Molizane/rc2014-ym2149/rc2014-ym2149-schematic.pdf

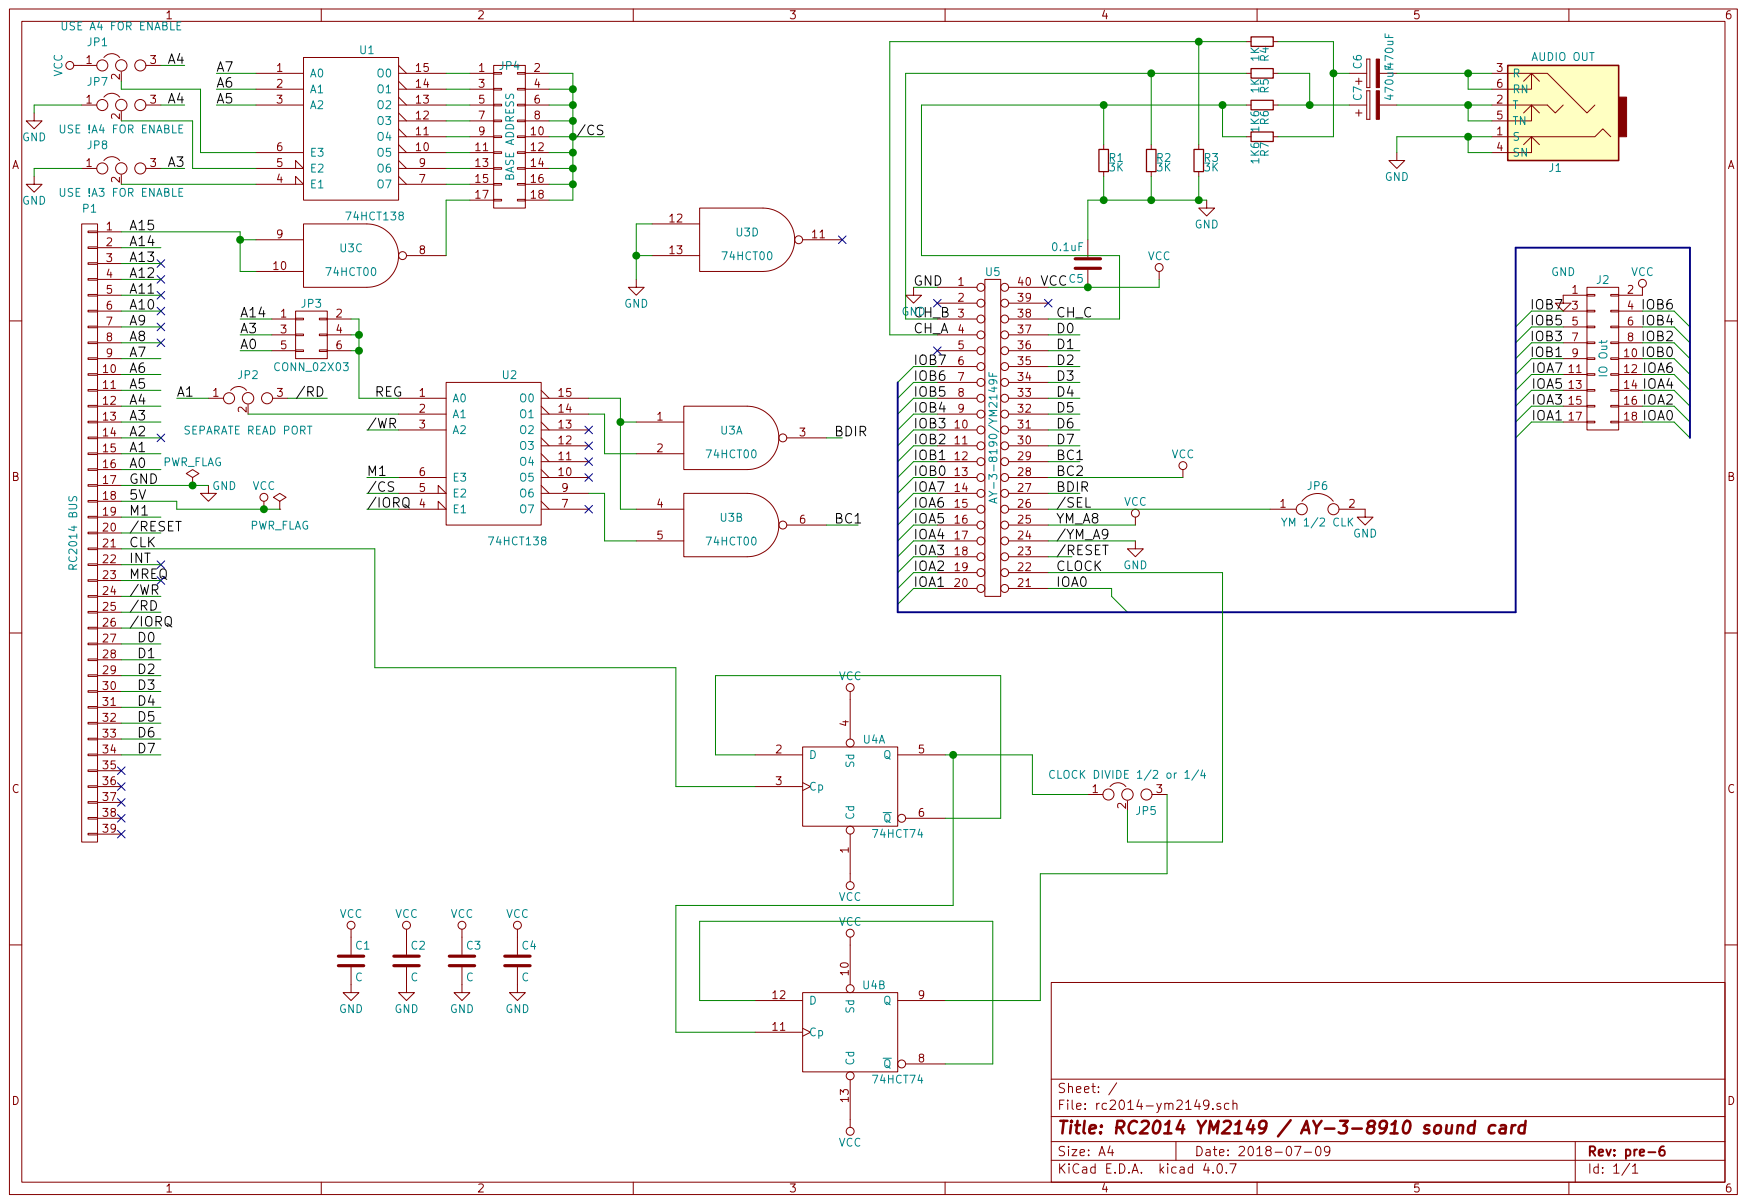
[picture p2: page 1]
