Molizane/rc2014-ym2149/rc2014-ym2149.sch

## KiCad design rc2014-ym2149.sch (2018-07-09)

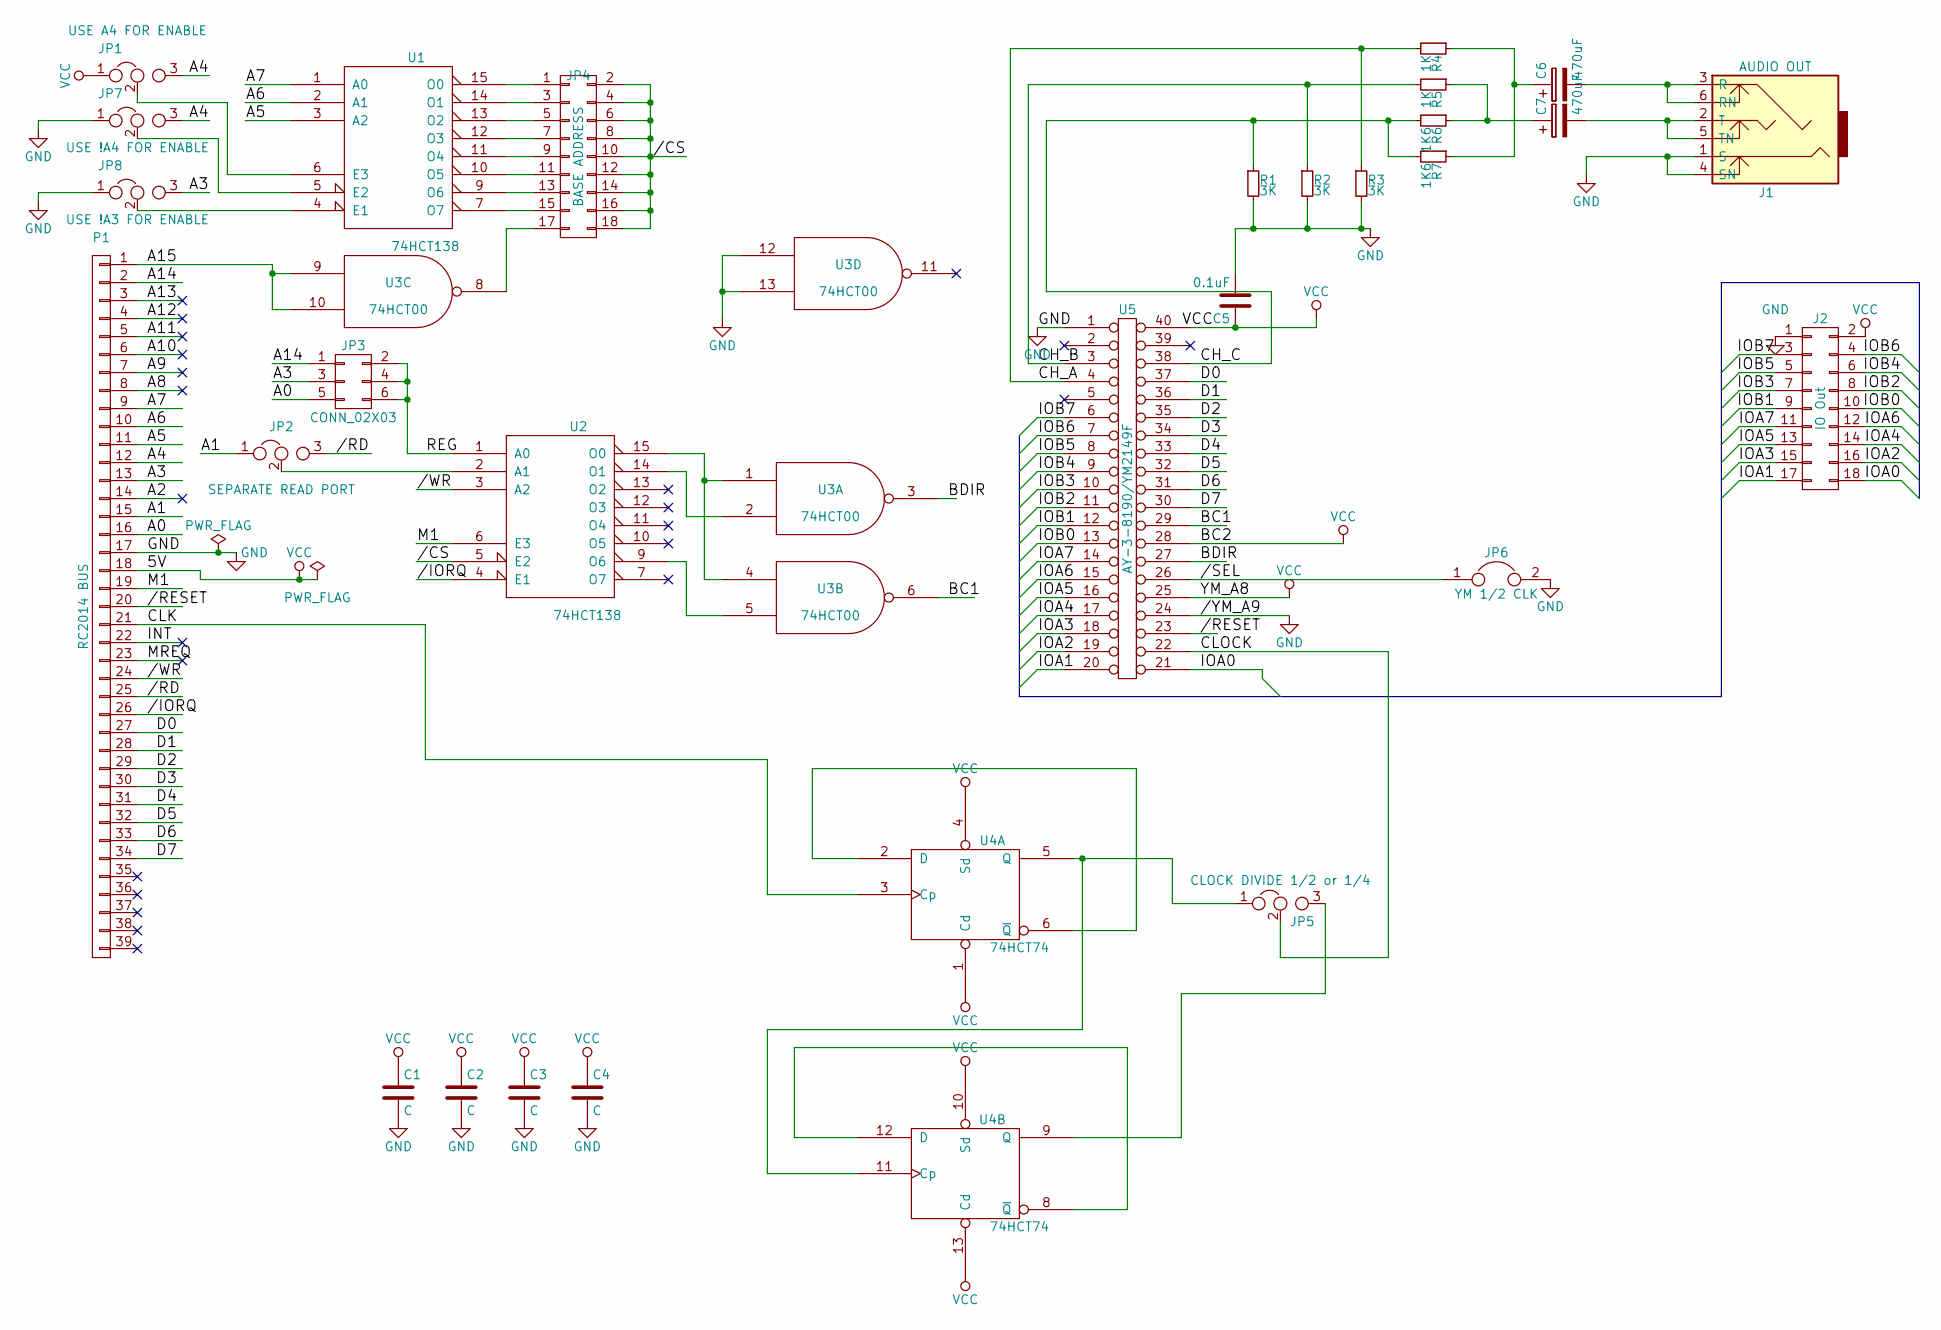
[picture p3: schematic rc2014-ym2149.sch]

Parts:
C1, C2, C3, C4: C; C_Disc_D3.8mm_W2.6mm_P2.50mm
C5: 0.1uF; C_Disc_D3.8mm_W2.6mm_P2.50mm
C6, C7: 470uF; CP_Radial_D6.3mm_P2.50mm
J1: AUDIO OUT; cliff_fcr1295_socket
J2: IO Out; Pin_Header_Straight_2x09_Pitch2.54mm
JP1: USE A4 FOR ENABLE; Pin_Header_Straight_1x03_Pitch2.54mm; MPN CONN 1x03
JP2: SEPARATE READ PORT; Pin_Header_Straight_1x03_Pitch2.54mm
JP3: CONN_02X03; Pin_Header_Straight_2x03_Pitch2.54mm
JP4: BASE ADDRESS; Pin_Header_Straight_2x08_Pitch2.54mm
JP5: CLOCK DIVIDE 1/2 or 1/4; Pin_Header_Straight_1x03_Pitch2.54mm
JP6: YM 1/2 CLK; Pin_Header_Straight_1x02_Pitch2.54mm
JP7: USE !A4 FOR ENABLE; Pin_Header_Straight_1x03_Pitch2.54mm; MPN CONN 1x03
JP8: USE !A3 FOR ENABLE; Pin_Header_Straight_1x03_Pitch2.54mm; MPN CONN 1x03
P1: RC2014 BUS; Pin_Header_Straight_1x39_Pitch2.54mm_NoSilk
R1: 3K; R_Axial_DIN0207_L6.3mm_D2.5mm_P10.16mm_Horizontal; MPN MF25 470R
R2, R3: 3K; R_Axial_DIN0207_L6.3mm_D2.5mm_P10.16mm_Horizontal
R4: 1K; R_Axial_DIN0207_L6.3mm_D2.5mm_P10.16mm_Horizontal; MPN MF25 1K
R5: 1K; R_Axial_DIN0207_L6.3mm_D2.5mm_P10.16mm_Horizontal
R6: 1K6; R_Axial_DIN0207_L6.3mm_D2.5mm_P10.16mm_Horizontal; MPN MF25 1K6
R7: 1K6; R_Axial_DIN0207_L6.3mm_D2.5mm_P10.16mm_Horizontal
U1, U2: 74HCT138; DIP-16_W7.62mm_Socket; MPN CD74HCT138E
U3: 74HCT00; DIP-14_W7.62mm_Socket
U4: 74HCT74; DIP-14_W7.62mm_Socket; MPN SN74HCT74N
U5: AY-3-8190/YM2149F; DIP-40_W15.24mm_Socket

Connections:
/CS: JP4.2, JP4.4, JP4.6, JP4.8, JP4.10, JP4.12, JP4.14, JP4.16, JP4.18, U2.5 (E2)
/IORQ: P1.26, U2.4 (E1)
/RD: JP2.3, P1.25
/RESET: P1.20, U5.23
/SEL: JP6.1, U5.26
/WR: P1.24, U2.3 (A2)
A0: JP3.5, P1.16
A1: JP2.1, P1.15
A2: P1.14
A3: JP3.3, JP8.3, P1.13
A4: JP1.3, JP7.3, P1.12
A5: P1.11, U1.3 (A2)
A6: P1.10, U1.2 (A1)
A7: P1.9, U1.1 (A0)
A8: P1.8
A9: P1.7
A10: P1.6
A11: P1.5
A12: P1.4
A13: P1.3
A14: JP3.1, P1.2
A15: P1.1, U3.9, U3.10
BC1: U3.6, U5.29
BDIR: U3.3, U5.27
CH_A: R3.1, R4.2, U5.4
CH_B: R2.1, R5.2, U5.3
CH_C: R1.1, R6.2, R7.2, U5.38
CLK: P1.21, U4.3 (Cp)
CLOCK: JP5.2, U5.22
D0: P1.27, U5.37
D1: P1.28, U5.36
D2: P1.29, U5.35
D3: P1.30, U5.34
D4: P1.31, U5.33
D5: P1.32, U5.32
D6: P1.33, U5.31
D7: P1.34, U5.30
GND: C1.2, C2.2, C3.2, C4.2, C5.2, J1.1 (S), J1.4 (SN), J2.1, JP6.2, JP7.1, JP8.1, P1.17, R1.2, R2.2, R3.2, U3.12, U3.13, U5.1, U5.24
INT: P1.22
IOA0: J2.18, U5.21
IOA1: J2.17, U5.20
IOA2: J2.16, U5.19
IOA3: J2.15, U5.18
IOA4: J2.14, U5.17
IOA5: J2.13, U5.16
IOA6: J2.12, U5.15
IOA7: J2.11, U5.14
IOB0: J2.10, U5.13
IOB1: J2.9, U5.12
IOB2: J2.8, U5.11
IOB3: J2.7, U5.10
IOB4: J2.6, U5.9
IOB5: J2.5, U5.8
IOB6: J2.4, U5.7
IOB7: J2.3, U5.6
M1: P1.19, U2.6 (E3)
MREQ: P1.23
unnamed: C6.1, R4.1, R7.1
unnamed: C6.2, J1.3 (R), J1.6 (RN)
unnamed: C7.1, R5.1, R6.1
unnamed: C7.2, J1.2 (T), J1.5 (TN)
unnamed: JP1.2, U1.6 (E3)
unnamed: JP2.2, U2.2 (A1)
unnamed: JP4.1, U1.15 (O0)
unnamed: JP4.3, U1.14 (O1)
unnamed: JP4.5, U1.13 (O2)
unnamed: JP4.7, U1.12 (O3)
unnamed: JP4.9, U1.11 (O4)
unnamed: JP4.11, U1.10 (O5)
unnamed: JP4.13, U1.9 (O6)
unnamed: JP4.15, U1.7 (O7)
unnamed: JP4.17, U3.8
unnamed: JP5.1, U4.5 (Q), U4.11 (Cp)
unnamed: JP5.3, U4.9 (Q)
unnamed: JP7.2, U1.5 (E2)
unnamed: JP8.2, U1.4 (E1)
unnamed: U2.9 (O6), U3.5
unnamed: U2.14 (O1), U3.2
unnamed: U2.15 (O0), U3.1, U3.4
unnamed: U4.2 (D), U4.6 (~Q)
unnamed: U4.8 (~Q), U4.12 (D)
REG: JP3.2, JP3.4, JP3.6, U2.1 (A0)
VCC: C1.1, C2.1, C3.1, C4.1, C5.1, J2.2, JP1.1, P1.18, U4.1 (Cd), U4.4 (Sd), U4.10 (Sd), U4.13 (Cd), U5.25, U5.28, U5.40
