Molizane/rc2014-ym2149/(commit log)

2018-06-20 Modified schematic to support MSX-compatible ports
    [rc2014-ym2149.sch]
2018-07-09 Modifications to schematic - now passes ERC
    [rc2014-ym2149.sch]
